trifrobert/Bachelor-Project/Graphical Resources/Tests/OverheatBatteryNotification.jpg

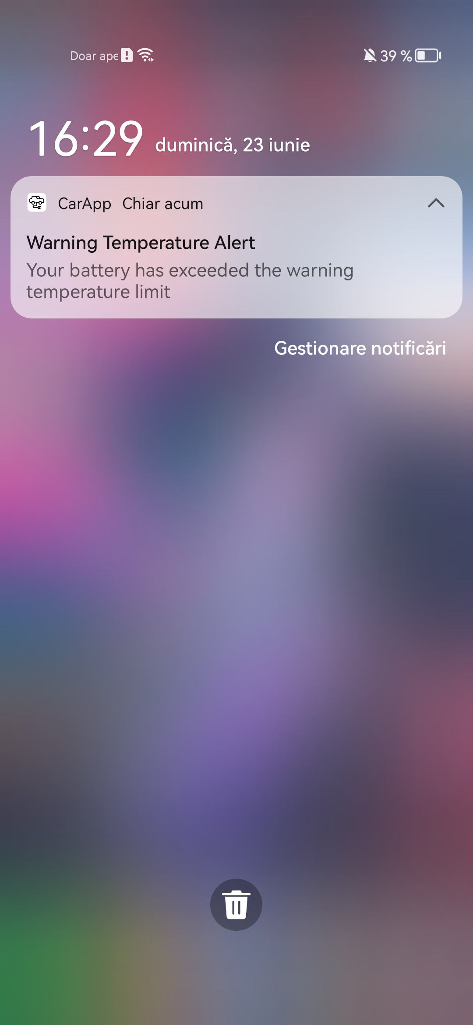
Graphical Resources/Tests/OverheatBatteryNotification.jpg
