trifrobert/Bachelor-Project/Graphical Resources/Tests/TestFullyChargedNotification.jpg

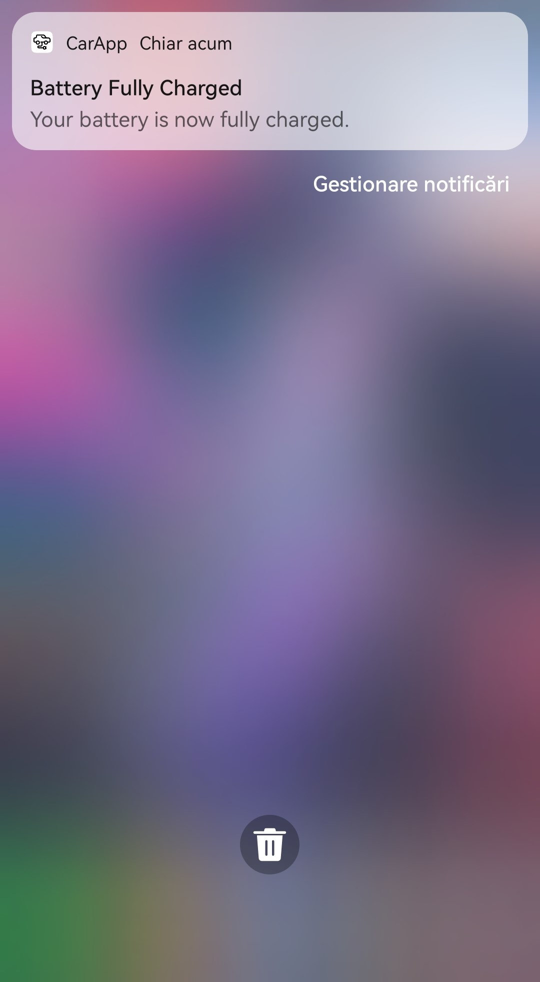
Graphical Resources/Tests/TestFullyChargedNotification.jpg
