trifrobert/Bachelor-Project/Graphical Resources/Code Snippets/chargingAlgorithm.png

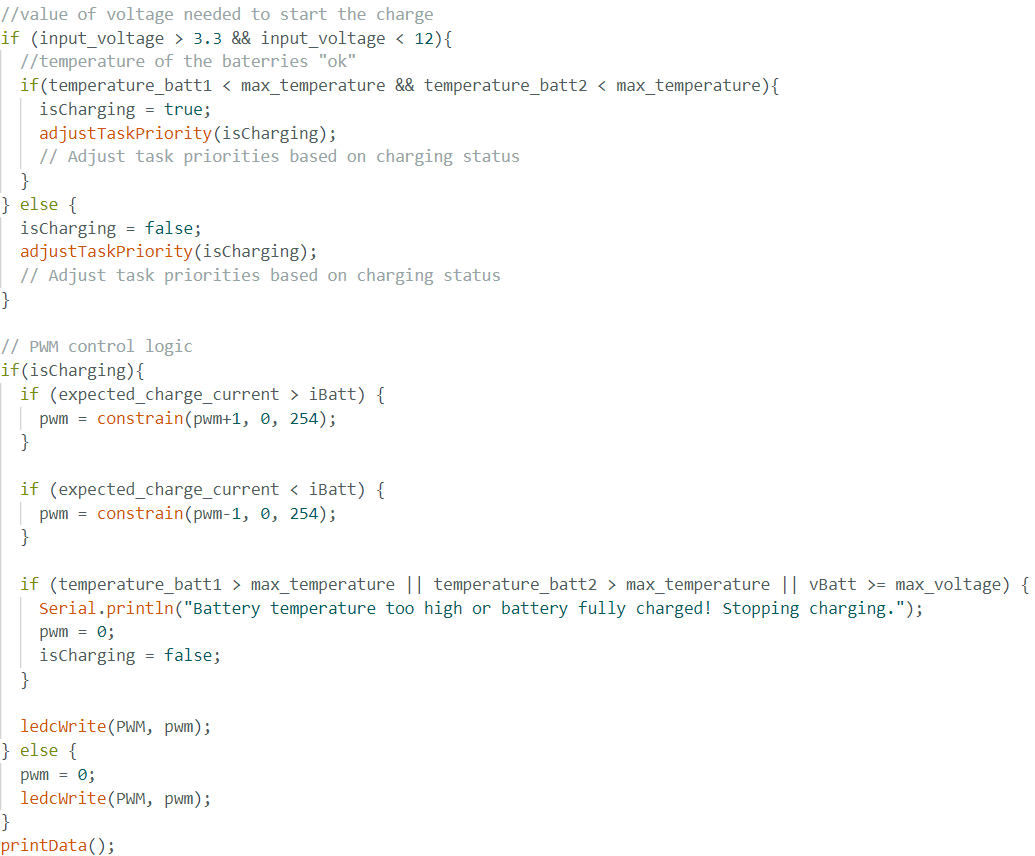
Graphical Resources/Code Snippets/chargingAlgorithm.png
