trifrobert/Bachelor-Project/Graphical Resources/Code Snippets/Expo project configuration.png

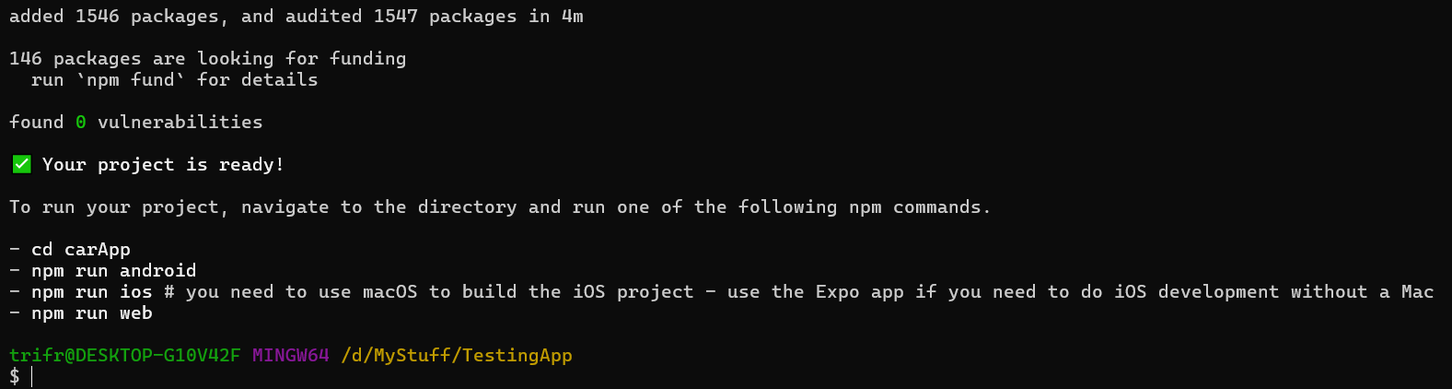
Graphical Resources/Code Snippets/Expo project configuration.png
