trifrobert/Bachelor-Project/Graphical Resources/Code Snippets/Firebase Admin SDK connection.png

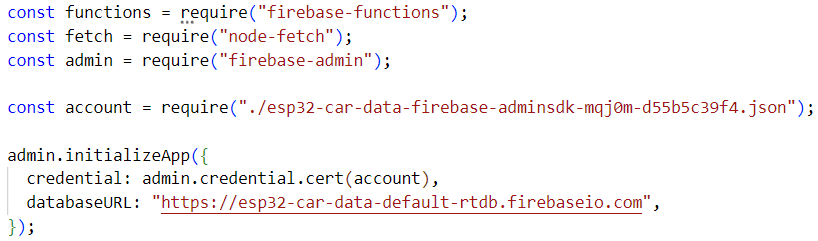
Graphical Resources/Code Snippets/Firebase Admin SDK connection.png
