trifrobert/Bachelor-Project/Graphical Resources/Code Snippets/Firebase connection.png

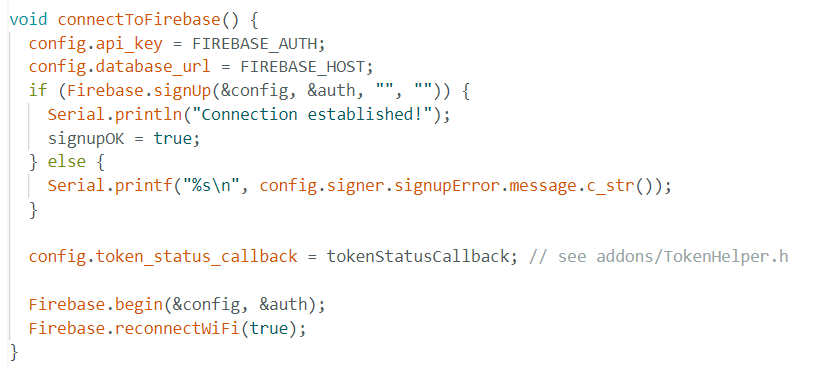
Graphical Resources/Code Snippets/Firebase connection.png
