trifrobert/Bachelor-Project/Graphical Resources/Code Snippets/Firebase console.jpg

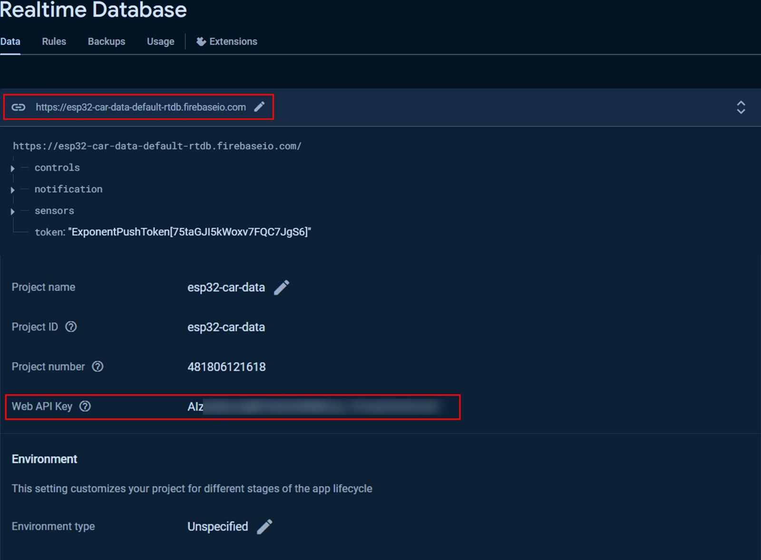
Graphical Resources/Code Snippets/Firebase console.jpg
