trifrobert/Bachelor-Project/Graphical Resources/Code Snippets/Firebase console.png

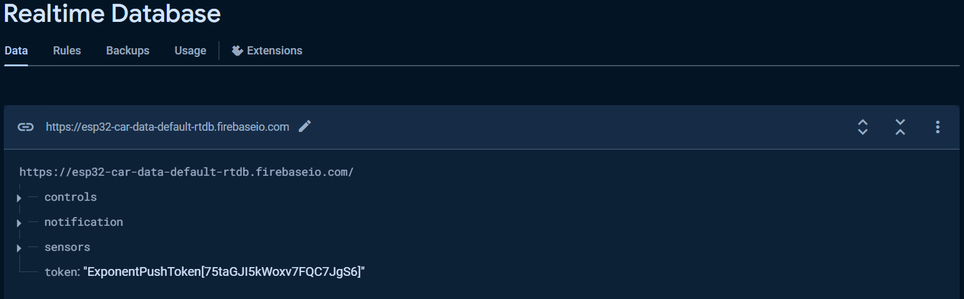
Graphical Resources/Code Snippets/Firebase console.png
