trifrobert/Bachelor-Project/Graphical Resources/Code Snippets/Firebase-Client Side.png

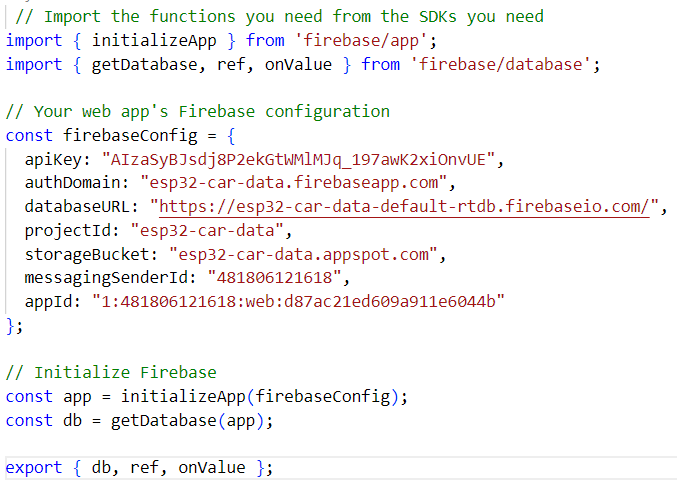
Graphical Resources/Code Snippets/Firebase-Client Side.png
