trifrobert/Bachelor-Project/Graphical Resources/Code Snippets/firebaseTask.png

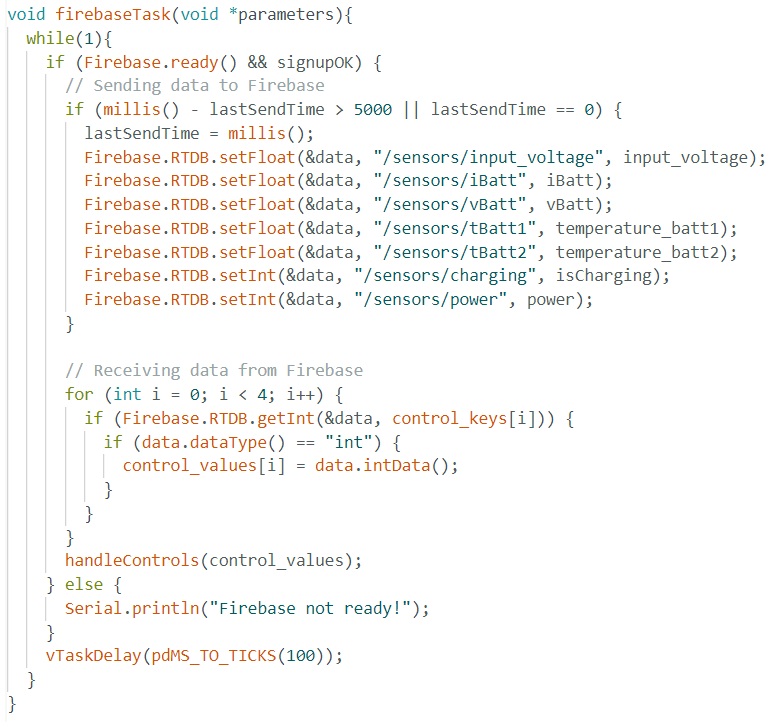
Graphical Resources/Code Snippets/firebaseTask.png
