trifrobert/Bachelor-Project/Graphical Resources/Code Snippets/getInputVoltage function.png

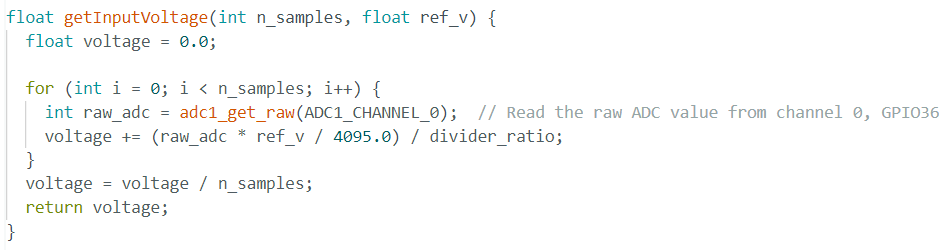
Graphical Resources/Code Snippets/getInputVoltage function.png
