trifrobert/Bachelor-Project/Graphical Resources/Code Snippets/HTTPS Request.png

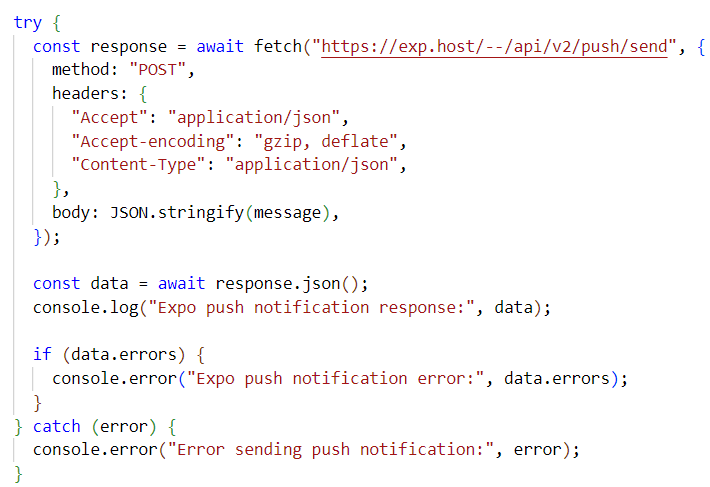
Graphical Resources/Code Snippets/HTTPS Request.png
