trifrobert/Bachelor-Project/Graphical Resources/Code Snippets/panResponder.png

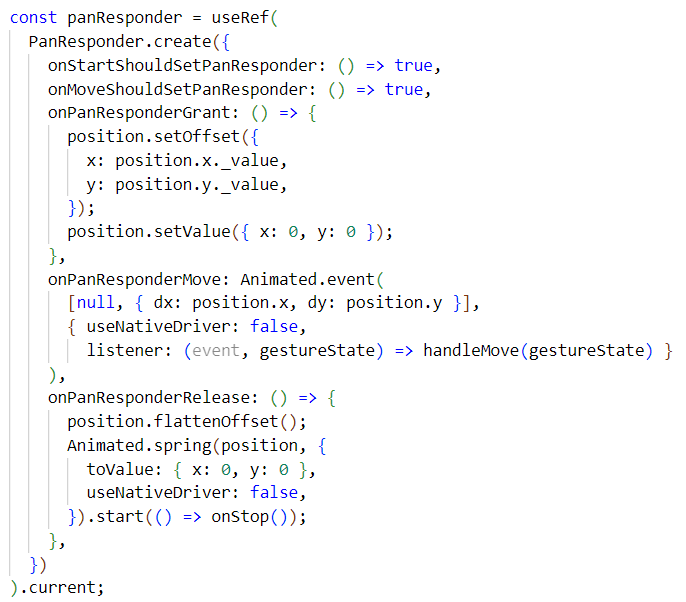
Graphical Resources/Code Snippets/panResponder.png
