trifrobert/Bachelor-Project/Graphical Resources/Code Snippets/Tasks.png

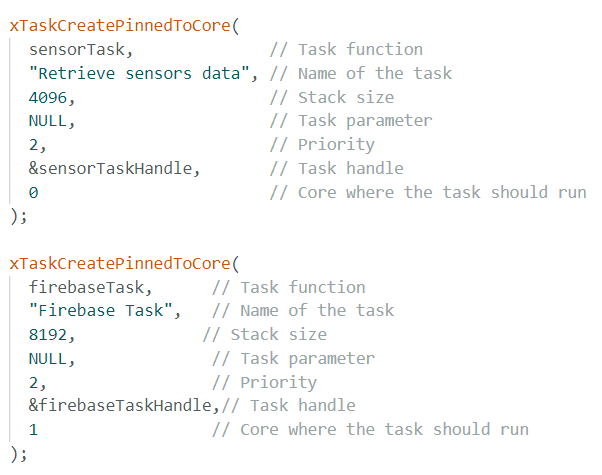
Graphical Resources/Code Snippets/Tasks.png
