trifrobert/Bachelor-Project/Graphical Resources/Code Snippets/Wi-Fi connection.png

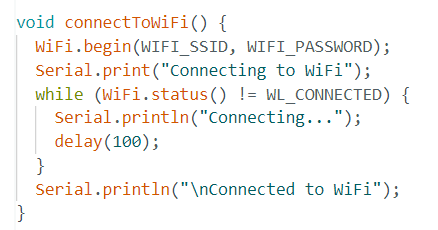
Graphical Resources/Code Snippets/Wi-Fi connection.png
