trifrobert/Bachelor-Project/Graphical Resources/Configure Expo project.png

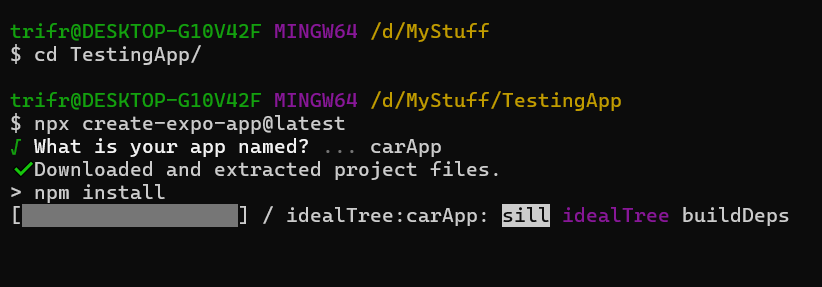
Graphical Resources/Configure Expo project.png
