trifrobert/Bachelor-Project/Graphical Resources/Electric Car Growth.png

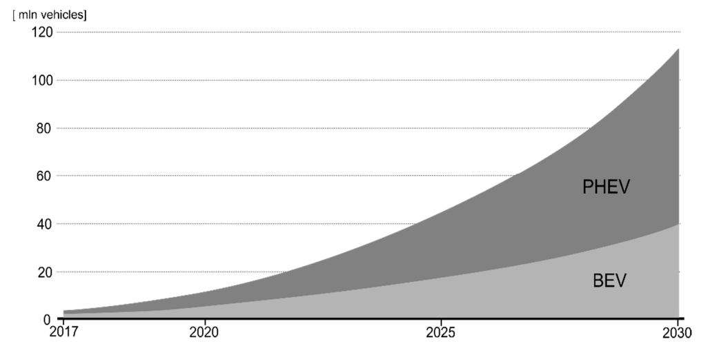
Graphical Resources/Electric Car Growth.png
