trifrobert/Bachelor-Project/Graphical Resources/handleControls().png

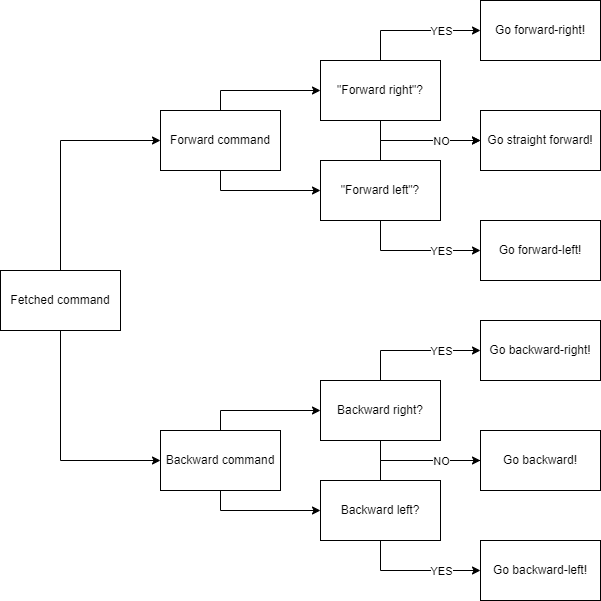
Graphical Resources/handleControls().png
