trifrobert/Bachelor-Project/Graphical Resources/INA219_Diagram.png

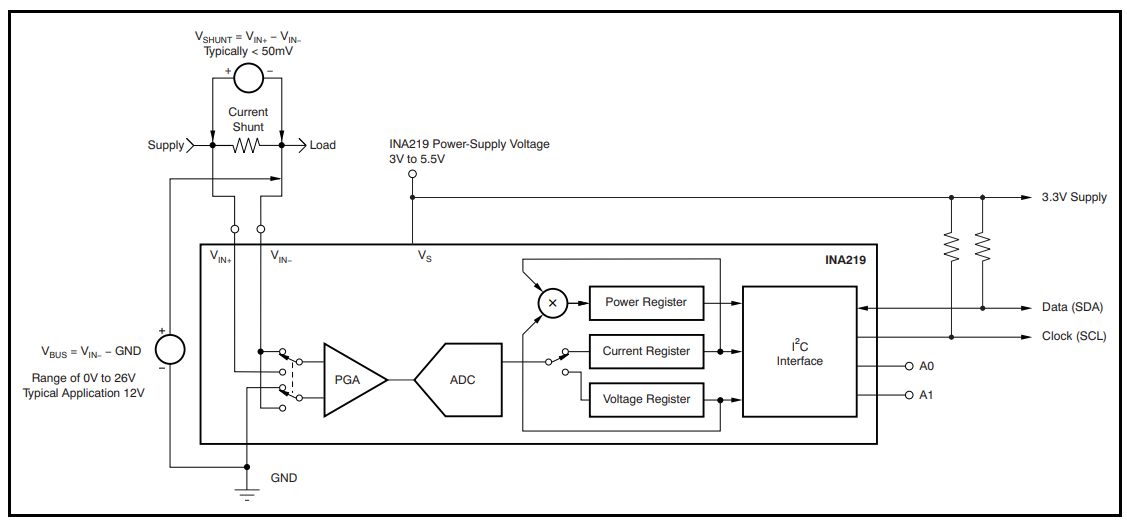
Graphical Resources/INA219_Diagram.png
