trifrobert/Bachelor-Project/Graphical Resources/Project Structure.png

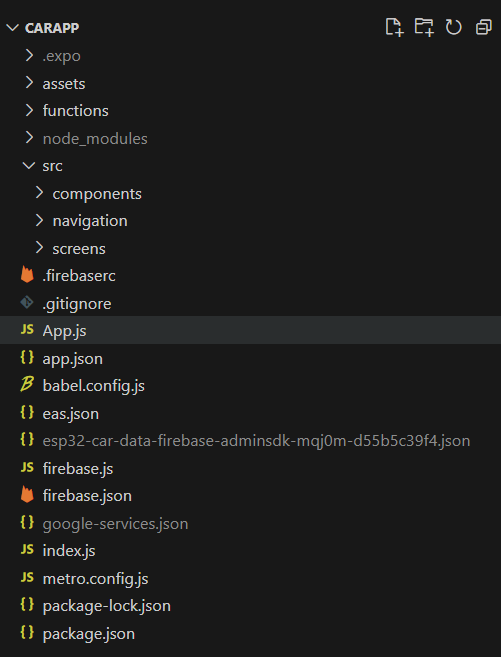
Graphical Resources/Project Structure.png
