trifrobert/Bachelor-Project/Graphical Resources/Use Case diagram.jpg

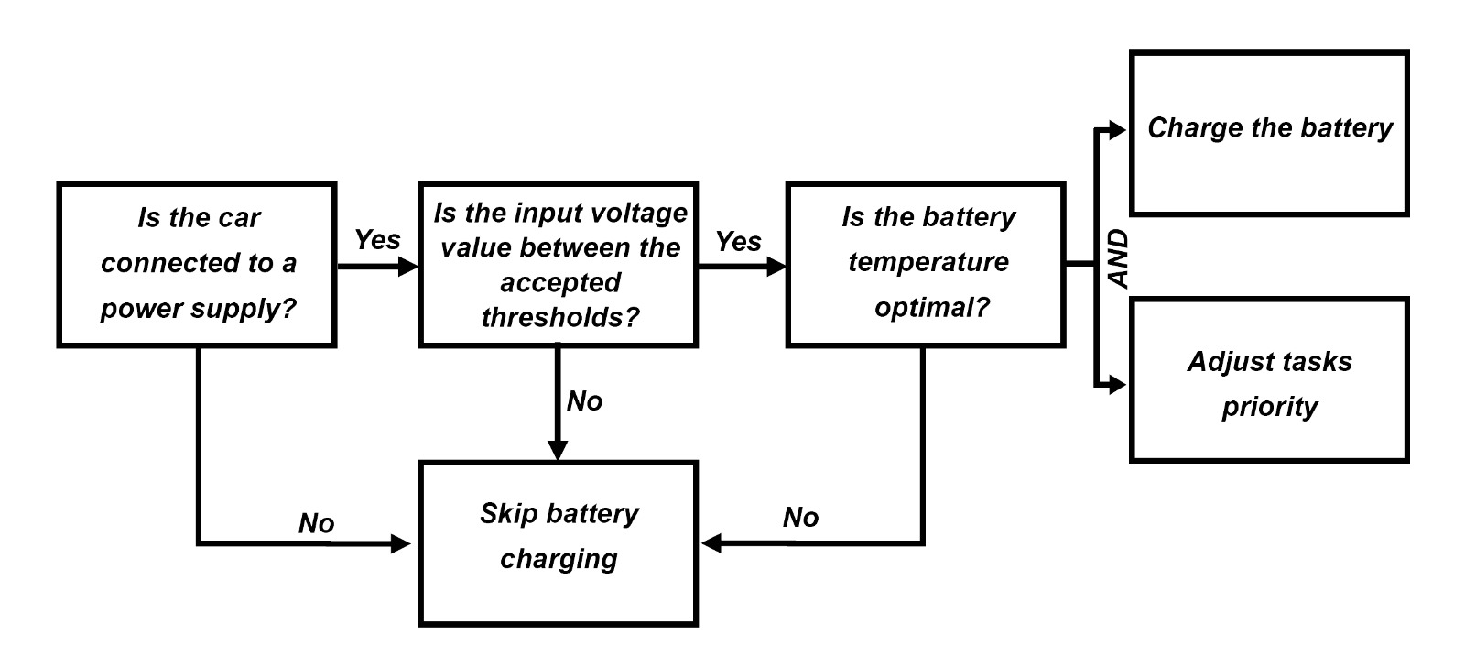
Graphical Resources/Use Case diagram.jpg
