trifrobert/Bachelor-Project/Graphical Resources/voltage 2.png

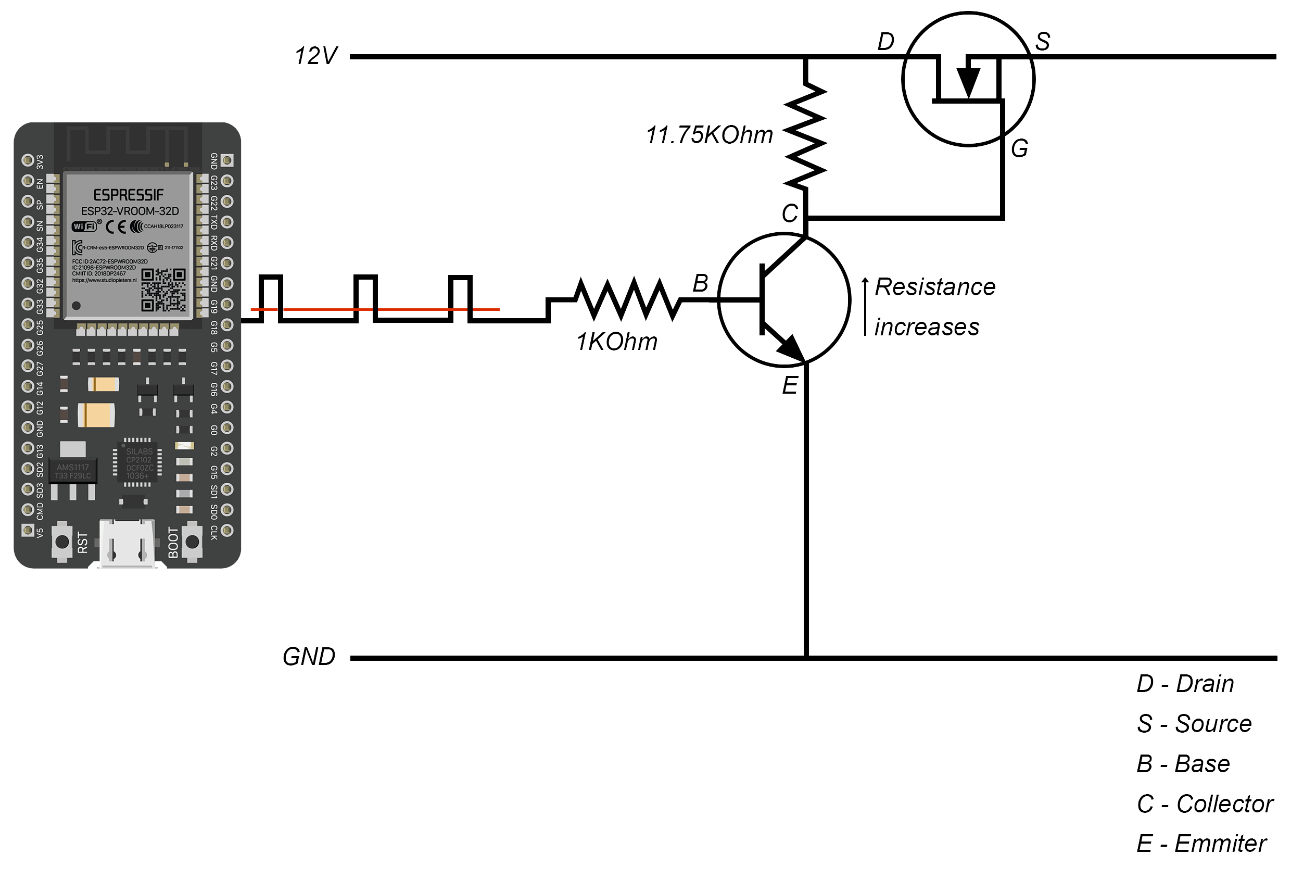
Graphical Resources/voltage 2.png
