trifrobert/Bachelor-Project/MobileApp/CarApp/assets/images/arrow_down.png

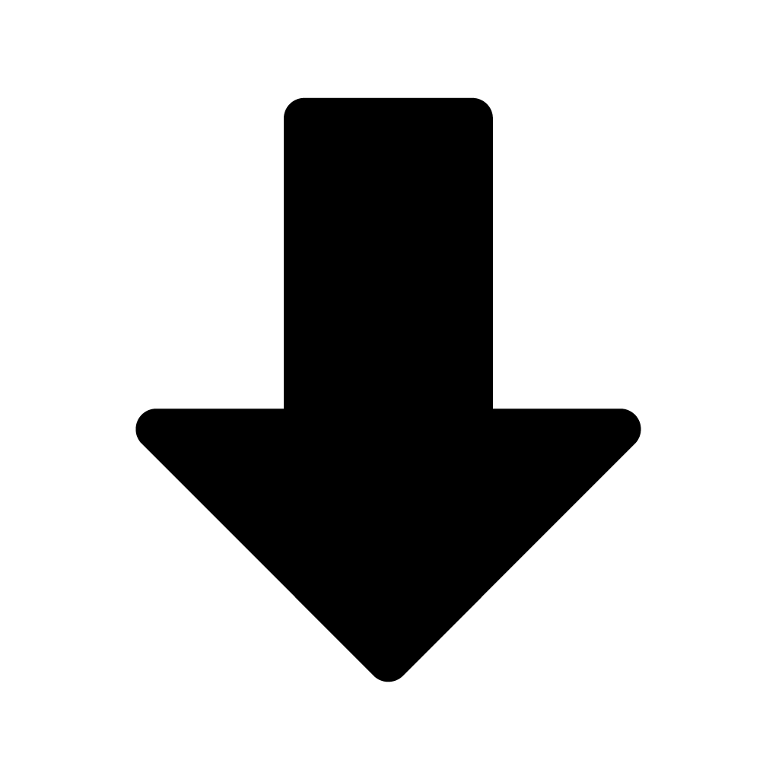
MobileApp/CarApp/assets/images/arrow_down.png
