trifrobert/Bachelor-Project/MobileApp/CarApp/assets/images/arrow_up.png

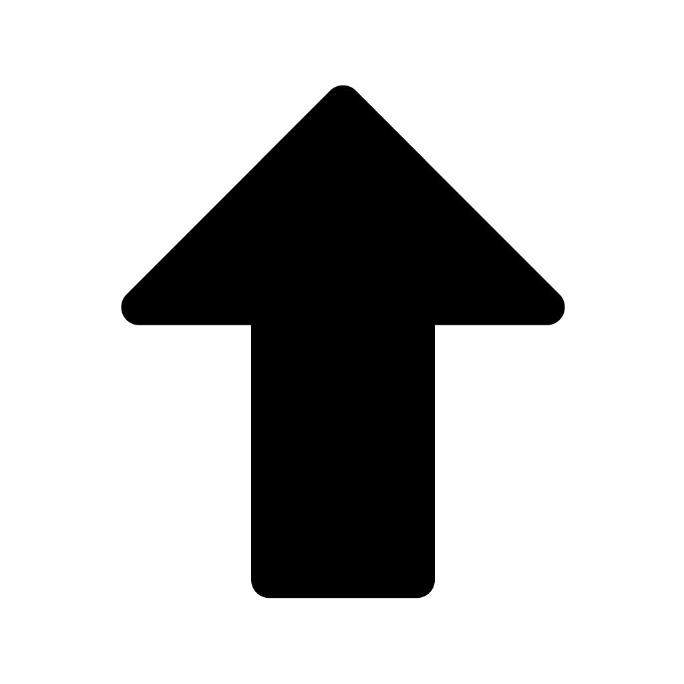
MobileApp/CarApp/assets/images/arrow_up.png
