trifrobert/Bachelor-Project/MobileApp/CarApp/assets/images/batt1.png

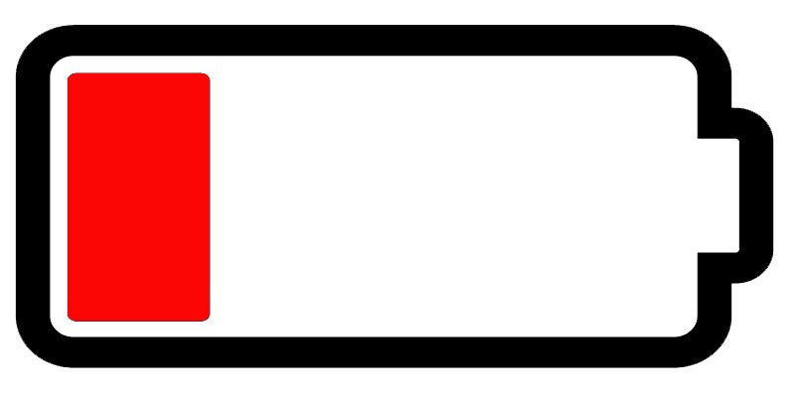
MobileApp/CarApp/assets/images/batt1.png
