trifrobert/Bachelor-Project/MobileApp/CarApp/assets/images/batt2.png

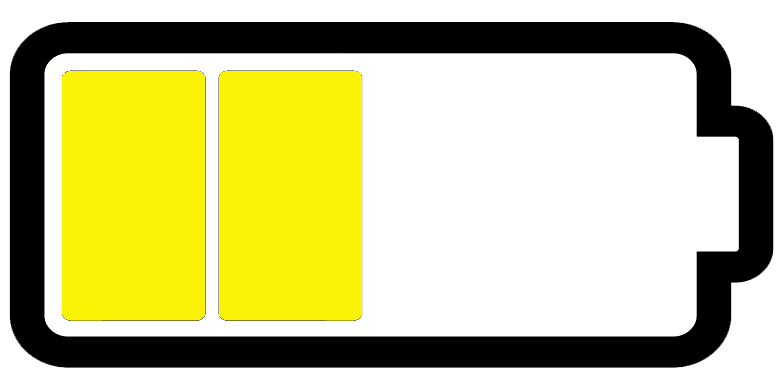
MobileApp/CarApp/assets/images/batt2.png
