trifrobert/Bachelor-Project/MobileApp/CarApp/assets/images/batt3.png

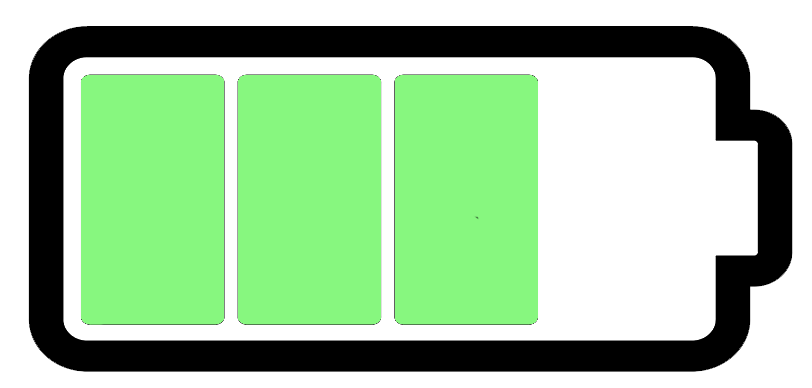
MobileApp/CarApp/assets/images/batt3.png
