trifrobert/Bachelor-Project/MobileApp/CarApp/assets/images/current.png

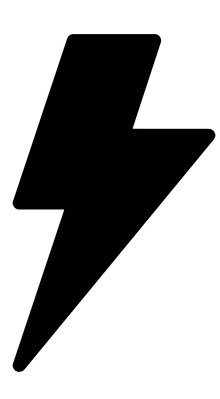
MobileApp/CarApp/assets/images/current.png
