trifrobert/Bachelor-Project/MobileApp/CarApp/assets/images/polarity.png

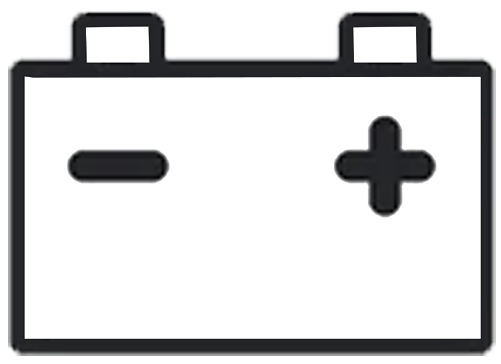
MobileApp/CarApp/assets/images/polarity.png
