trifrobert/Bachelor-Project/Graphical Resources/Code Snippets/ButtonComponent.png

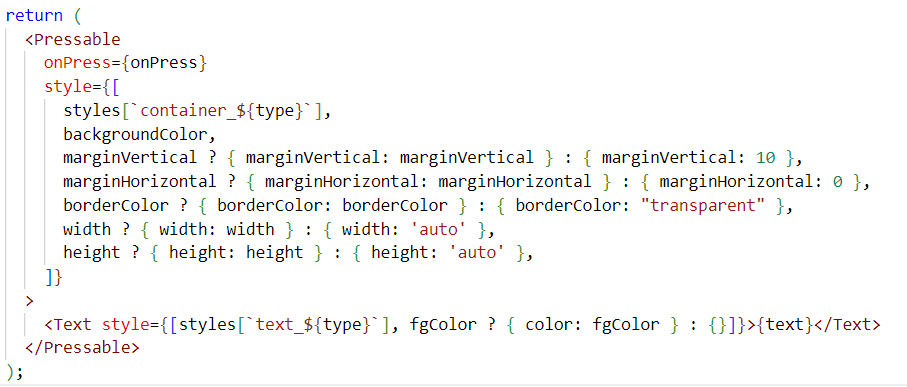
Graphical Resources/Code Snippets/ButtonComponent.png
