trifrobert/Bachelor-Project/Graphical Resources/Controller component.png

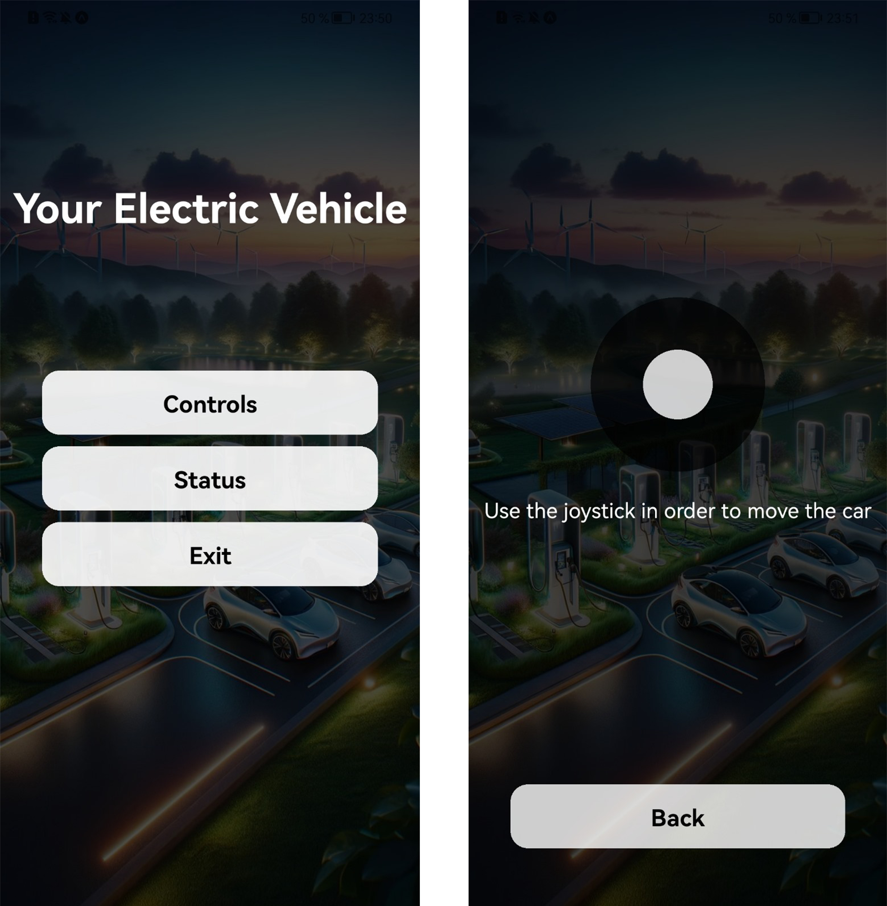
Graphical Resources/Controller component.png
