trifrobert/Bachelor-Project/Graphical Resources/View component.png

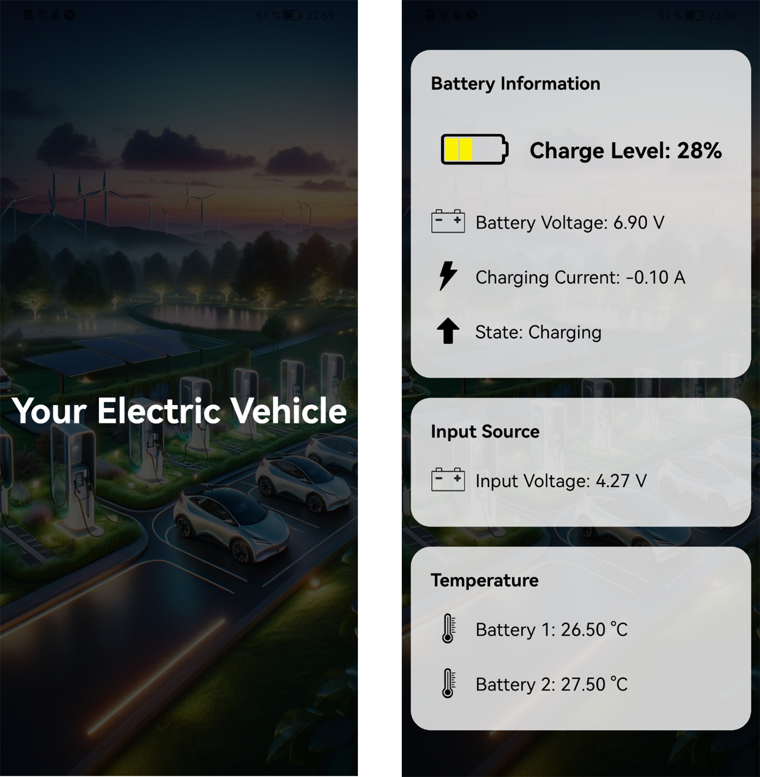
Graphical Resources/View component.png
