trifrobert/Bachelor-Project/(list of files, cad)

Other CAD files:
3D_Sasiu/Chassis.3dm
