trifrobert/Bachelor-Project/Graphical Resources/Tests/Battery Temperatures.png

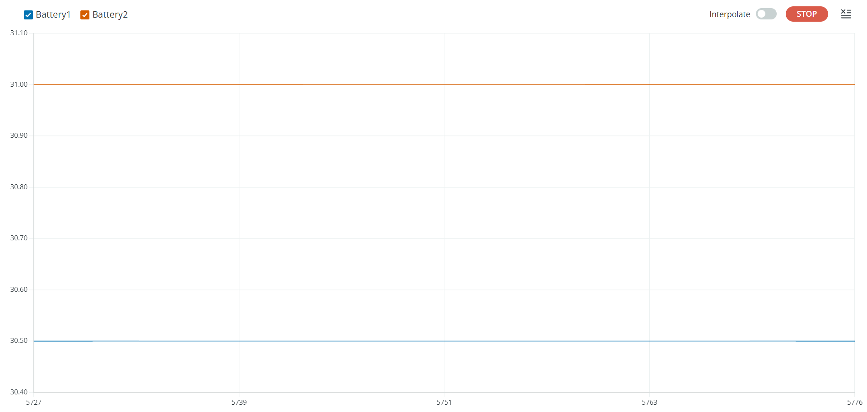
Graphical Resources/Tests/Battery Temperatures.png
