trifrobert/Bachelor-Project/Graphical Resources/Tests/Charging State and Input Voltage.png

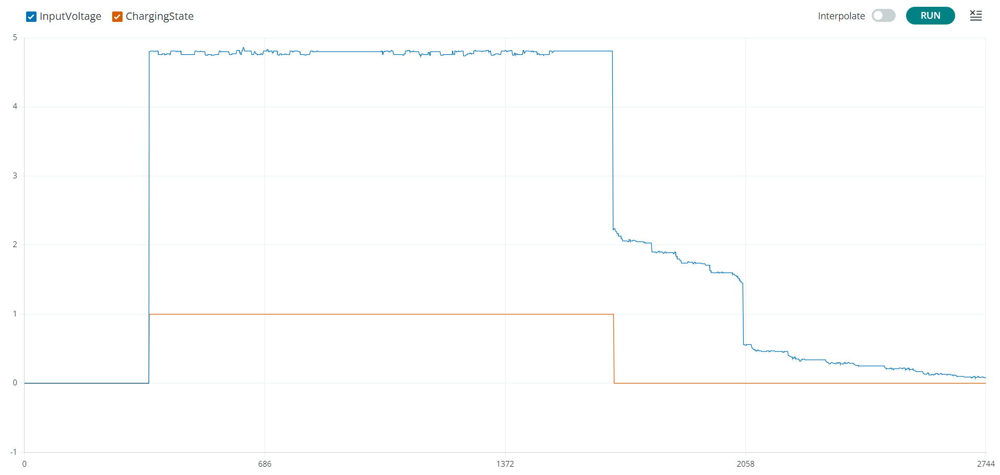
Graphical Resources/Tests/Charging State and Input Voltage.png
