trifrobert/Bachelor-Project/Graphical Resources/Tests/Current Sensor.png

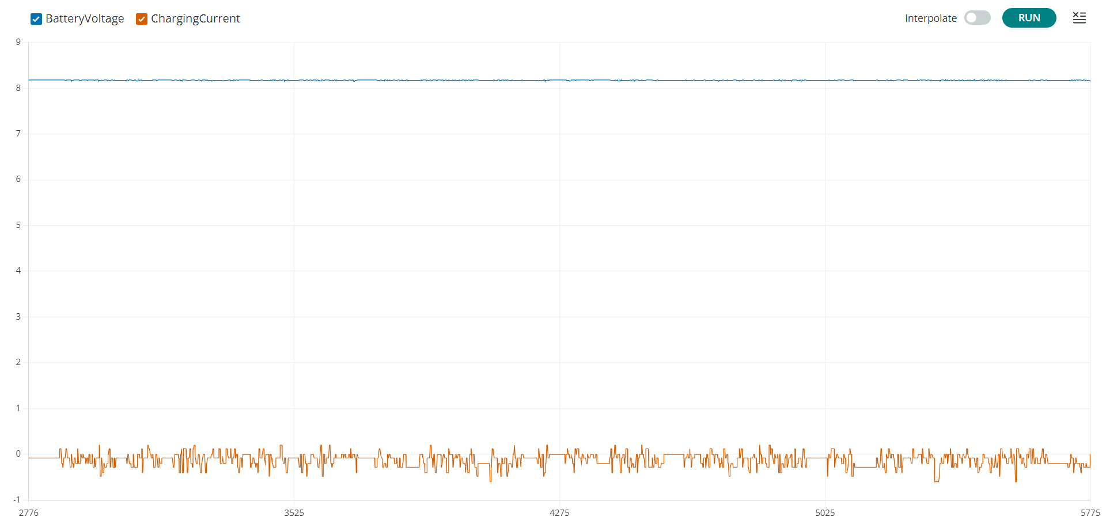
Graphical Resources/Tests/Current Sensor.png
