trifrobert/Bachelor-Project/Graphical Resources/Tests/Discharged.jpg

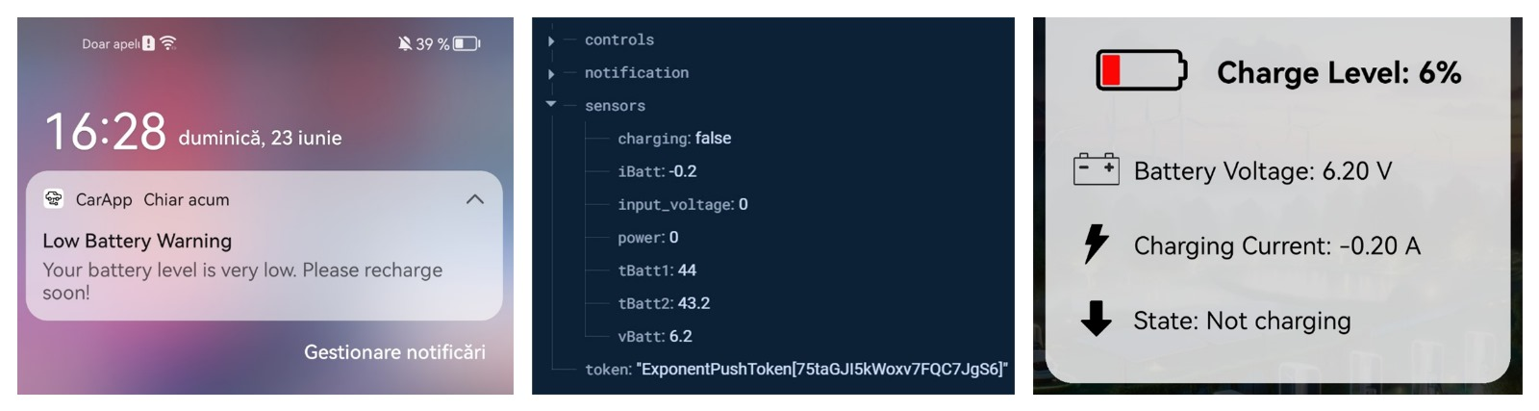
Graphical Resources/Tests/Discharged.jpg
