trifrobert/Bachelor-Project/Graphical Resources/Tests/Distance.png

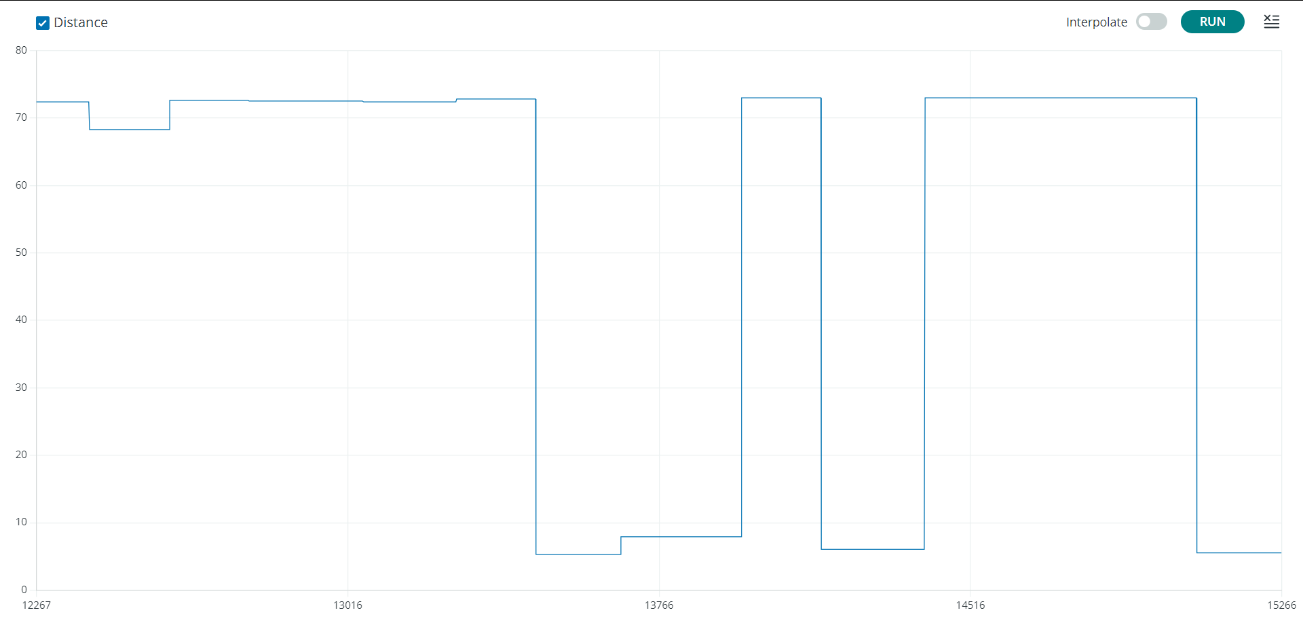
Graphical Resources/Tests/Distance.png
