trifrobert/Bachelor-Project/Graphical Resources/Tests/FullyCharged.jpg

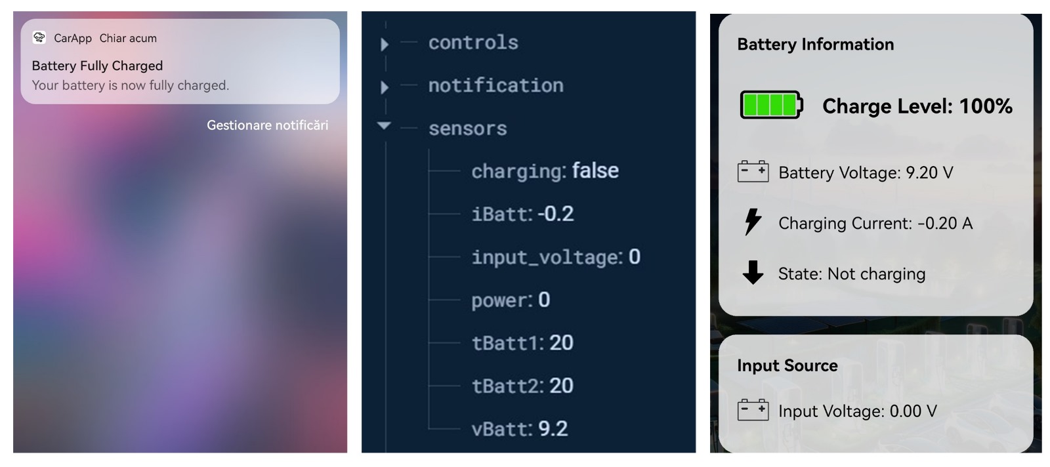
Graphical Resources/Tests/FullyCharged.jpg
