trifrobert/Bachelor-Project/Graphical Resources/Tests/LowBatteryApplication.jpg

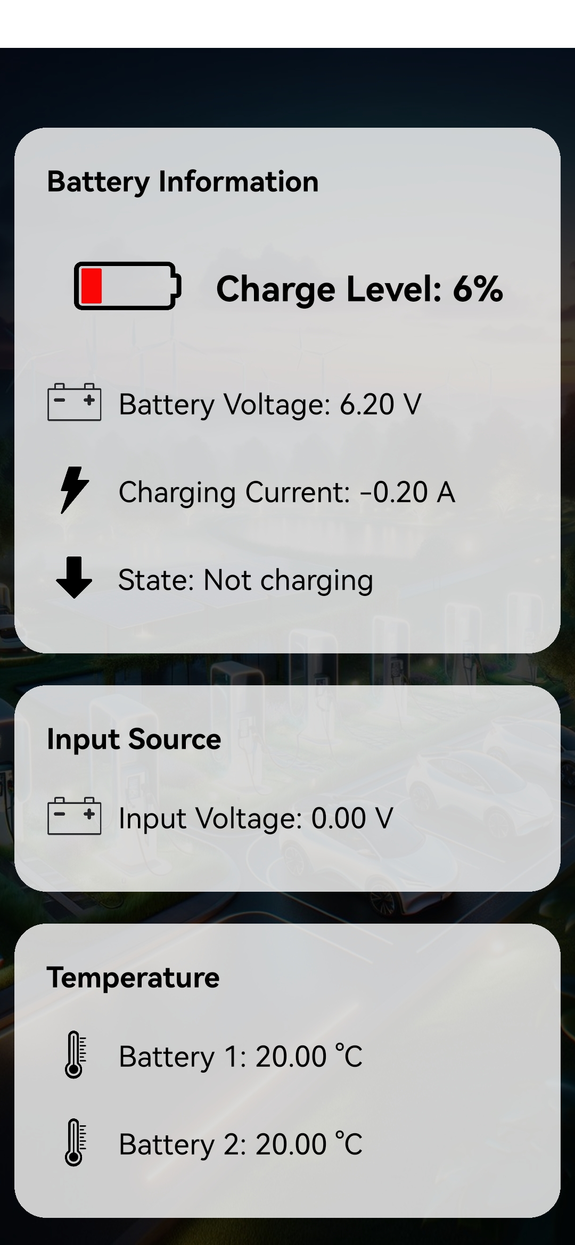
Graphical Resources/Tests/LowBatteryApplication.jpg
