trifrobert/Bachelor-Project/Graphical Resources/Tests/LowBatteryConsole.png

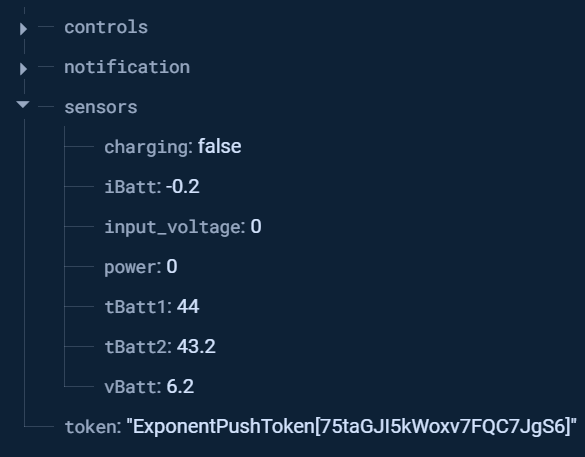
Graphical Resources/Tests/LowBatteryConsole.png
