trifrobert/Bachelor-Project/Graphical Resources/Tests/PWM.png

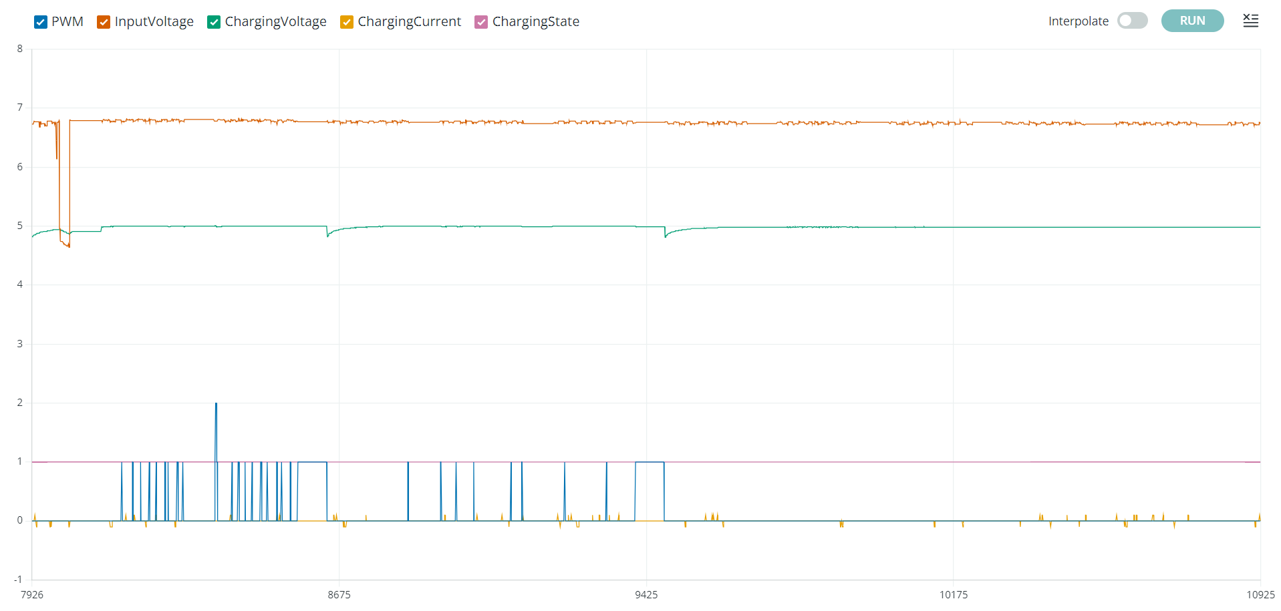
Graphical Resources/Tests/PWM.png
