trifrobert/Bachelor-Project/Graphical Resources/Tests/Temperature Exeeded.png

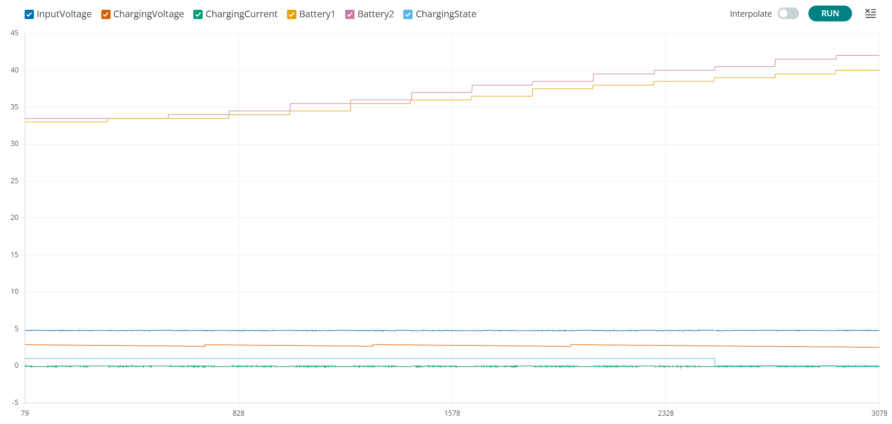
Graphical Resources/Tests/Temperature Exeeded.png
