trifrobert/Bachelor-Project/Graphical Resources/Tests/TestFullyCharged.png

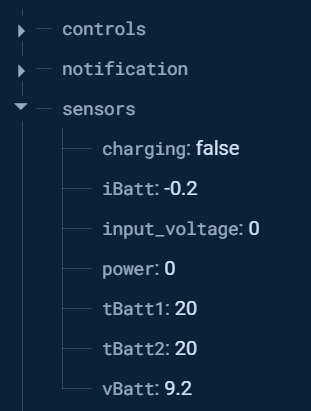
Graphical Resources/Tests/TestFullyCharged.png
