trifrobert/Bachelor-Project/Graphical Resources/Tests/TestFullyChargedApplication.jpg

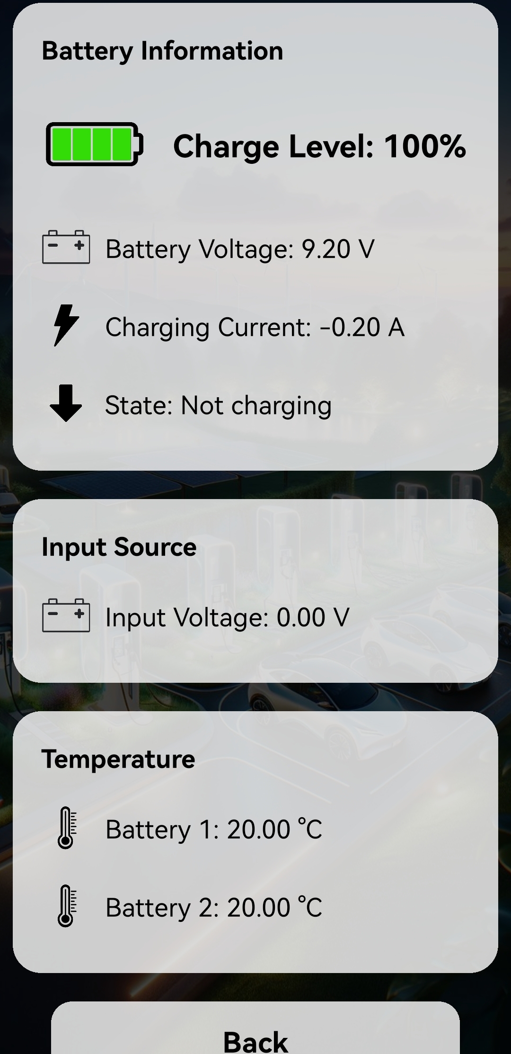
Graphical Resources/Tests/TestFullyChargedApplication.jpg
