trifrobert/Bachelor-Project/ESP32_Code/Code/Code.ino

#include <Wire.h>
#include <OneWire.h>
#include <DallasTemperature.h>
#include <Adafruit_INA219.h>
#include <driver/adc.h>
#include <WiFi.h>
#include <Firebase_ESP_Client.h>
#include "addons/TokenHelper.h"
#include "addons/RTDBHelper.h"
#include "FirebaseConfig.h"

#define ONE_WIRE_BUS 32   // Temperature Sensors configuration pin

// Ultrasonic sensor
const int echoPin = 15;
const int trigPin = 16;
const int pUltraSonic = 17;
float duration, distance;

// Wi-Fi and Realtime Database Connection
WiFiClient wifiClient;
FirebaseData data;
FirebaseAuth auth;
FirebaseConfig config;
bool signupOK = false;
unsigned long lastSendTime = 0;
unsigned long lastTempSent = 0;

Adafruit_INA219 ina_219;  // Instance of current module
float input_voltage = 0;    // Volts
float iBatt = 0;  // Charging current - mAmpers
float vBatt = 0;    // Battery voltage - Volts
float power = 0;  // Charging power - mW

const int PWM = 23;   // Corresponds to GPIO23
const int pwm_channel = 6;
const int frequency = 30000;   // Hz
const int resolution = 8; 
int pwm = 0;
bool isCharging = false;

const float expected_charge_current = 20; // Constant charging current in mA (0.05C for 400mAh batteries) for trickle charge
const float max_temperature = 40;     // Maximum temperature in °C
const float max_voltage = 9.2;    // Maximum voltage for two 9V NiMH batteries in parallel

// Motor driver configuration
int motorspeed_l = 33;
int leftMotors_pin1 = 25;
int leftMotors_pin2 = 26;
int rightMotors_pin1 = 27;
int rightMotors_pin2 = 14;
int motorspeed_r = 12;

// Access for Dallas temperature sensors
OneWire oneWire(ONE_WIRE_BUS);
DallasTemperature sensors(&oneWire);
DeviceAddress sensor1, sensor2;
float temperature_batt1 = 0;
float temperature_batt2 = 0;

const float divider_ratio = 0.2985;   // Voltage divider ratio based on resistances value: 10 / (23.5 + 10)

const char* control_keys[4] = {"/controls/control_up", "/controls/control_down", "/controls/control_left", "/controls/control_right"};
int control_values[4];

TaskHandle_t firebaseTaskHandle;
TaskHandle_t sensorTaskHandle;

float getInputVoltage(int n_samples, float ref_v) {
  float voltage = 0.0;

  for (int i = 0; i < n_samples; i++) {
    int raw_adc = adc1_get_raw(ADC1_CHANNEL_0);  // Read the raw ADC value from channel 0, GPIO36
    voltage += (raw_adc * ref_v / 4095.0) / divider_ratio;
  }
  voltage = voltage / n_samples;
  return voltage;
}

void connectToWiFi() {
  WiFi.begin(WIFI_SSID, WIFI_PASSWORD);
  Serial.print("Connecting to WiFi");
  while (WiFi.status() != WL_CONNECTED) {
    Serial.println("Connecting...");
    delay(100);
  }
  Serial.println("\nConnected to WiFi");
}

void connectToFirebase() {
  config.api_key = FIREBASE_AUTH;
  config.database_url = FIREBASE_HOST;
  if (Firebase.signUp(&config, &auth, "", "")) {
    Serial.println("Connection established!");
    signupOK = true;
  } else {
    Serial.printf("%s\n", config.signer.signupError.message.c_str());
  }

  config.token_status_callback = tokenStatusCallback; // see addons/TokenHelper.h

  Firebase.begin(&config, &auth);
  Firebase.reconnectWiFi(true);
}

void handleControls(int control_arr[]){
  if(control_arr[0] == 1){
    if(control_arr[2] == 1){
      //FRONT-LEFT
      digitalWrite(leftMotors_pin1, LOW);
      digitalWrite(leftMotors_pin2, LOW);
      digitalWrite(rightMotors_pin1, HIGH);
      digitalWrite(rightMotors_pin2, LOW);
    }
    else if(control_arr[3] == 1){
      //FRONT-RIGHT
      digitalWrite(leftMotors_pin1, LOW);
      digitalWrite(leftMotors_pin2, HIGH);
      digitalWrite(rightMotors_pin1, LOW);
      digitalWrite(rightMotors_pin2, LOW);
    }
    else{
      //FRONT
      digitalWrite(leftMotors_pin1, LOW);
      digitalWrite(leftMotors_pin2, HIGH);
      digitalWrite(rightMotors_pin1, HIGH);
      digitalWrite(rightMotors_pin2, LOW);
    }
  }
  else if(control_arr[1] == 1){
    
    digitalWrite(trigPin, LOW);
    delayMicroseconds(2);
    digitalWrite(trigPin, HIGH);
    delayMicroseconds(10);
    digitalWrite(trigPin, LOW);
    
    duration = pulseIn(echoPin, HIGH);
    distance = duration / 58.2;

    if (distance > 8){
      if(control_arr[2] == 1){
        //BACKWARD-LEFT
        digitalWrite(leftMotors_pin1, LOW);
        digitalWrite(leftMotors_pin2, LOW);
        digitalWrite(rightMotors_pin1, LOW);
        digitalWrite(rightMotors_pin2, HIGH);
      }
      else if(control_arr[3] == 1){
        //BACKWARD-RIGHT
        digitalWrite(leftMotors_pin1, HIGH);
        digitalWrite(leftMotors_pin2, LOW);
        digitalWrite(rightMotors_pin1, LOW);
        digitalWrite(rightMotors_pin2, LOW);
      }
      else{
        //BACKWARD
        digitalWrite(leftMotors_pin1, HIGH);
        digitalWrite(leftMotors_pin2, LOW);
        digitalWrite(rightMotors_pin1, LOW);
        digitalWrite(rightMotors_pin2, HIGH);
      }
    }
  }
  else{
    //STATIONARY
    digitalWrite(leftMotors_pin1, LOW);
    digitalWrite(leftMotors_pin2, LOW);
    digitalWrite(rightMotors_pin1, LOW);
    digitalWrite(rightMotors_pin2, LOW);
  }
}

void printData(void) {
  Serial.print("PWM Value: ");
  Serial.println(pwm);
  Serial.print("Input voltage:         "); Serial.print(input_voltage); Serial.println(" V");
  Serial.print("Battery Voltage:       "); Serial.print(vBatt); Serial.println(" V");
  Serial.print("Charging Current:      "); Serial.print(iBatt); Serial.println(" mA");
  Serial.print("Power:                 "); Serial.print(power); Serial.println(" mW");
  Serial.print("Battery 1 Temperature: "); Serial.print(temperature_batt1); Serial.println(" °C");
  Serial.print("Battery 2 Temperature: "); Serial.print(temperature_batt2); Serial.println(" °C");
  Serial.print("Charging:              "); Serial.println(isCharging);
  Serial.print("Distance:              "); Serial.print(distance); Serial.println(" cm");
  Serial.println();
}

void printDataForPlotter(void) {
  // Serial.print("PWM:");
  // Serial.print(pwm);
  // Serial.print(",");
  Serial.print("InputVoltage:");
  Serial.print(input_voltage);
  Serial.print(",");
  Serial.print("ChargingVoltage:");
  Serial.print(vBatt);
  Serial.print(",");
  Serial.print("ChargingCurrent:");
  Serial.print(iBatt);
  Serial.print(",");
  // Serial.print(power);
  // Serial.print(",");
  Serial.print("Battery1:");
  Serial.print(temperature_batt1);
  Serial.print(",");
  Serial.print("Battery2:");
  Serial.print(temperature_batt2);
  Serial.print(",");
  Serial.print("ChargingState:");
  Serial.print(isCharging);
  Serial.print(",");
  // Serial.print("Distance:");
  // Serial.print(distance);
  Serial.println();
}

void adjustTaskPriority(bool isCharging){
  if(isCharging){
    vTaskPrioritySet(firebaseTaskHandle, 1);
    vTaskPrioritySet(sensorTaskHandle, 3);
  }
  else{
    vTaskPrioritySet(firebaseTaskHandle, 2);
    vTaskPrioritySet(sensorTaskHandle, 2);
  }
}

void sensorTask(void *parameters){
  while(1){
    input_voltage = getInputVoltage(10, 3.3);
    iBatt = ina_219.getCurrent_mA();
    vBatt = ina_219.getBusVoltage_V() + (ina_219.getShuntVoltage_mV() / 1000);
    power = ina_219.getPower_mW();

    if (millis() - lastTempSent > 2000 || lastTempSent == 0) {
      lastTempSent = millis();
      sensors.requestTemperatures();
      temperature_batt1 = sensors.getTempC(sensor1);
      temperature_batt2 = sensors.getTempC(sensor2);
    }

    //value of voltage needed to start the charge
    if (input_voltage > 3.3 && input_voltage < 12){  
      //temperature of the baterries "ok"
      if(temperature_batt1 < max_temperature && temperature_batt2 < max_temperature){   
        isCharging = true;
        adjustTaskPriority(isCharging);
        // Adjust task priorities based on charging status
      }
    } else {
      isCharging = false;
      adjustTaskPriority(isCharging);
      // Adjust task priorities based on charging status
    }

    // PWM control logic
    if(isCharging){
      // if (expected_charge_current > iBatt) {
      //   pwm = constrain(pwm+1, 0, 254);
      // }

      // if (expected_charge_current < iBatt) {
      //   pwm = constrain(pwm-1, 0, 254);
      // }

      if (2.75 < vBatt) {
        pwm = constrain(pwm+1, 0, 254);
      }

      if (2.75 > vBatt) {
        pwm = constrain(pwm-1, 0, 254);
      }

      if (temperature_batt1 > max_temperature || temperature_batt2 > max_temperature || vBatt >= max_voltage) {
        Serial.println("Battery temperature too high or battery fully charged! Stopping charging.");
        pwm = 254;
        isCharging = false;
      }

      ledcWrite(PWM, pwm);
    } else {
      pwm = 254;
      ledcWrite(PWM, pwm);
    }
    // printData();
    vTaskDelay(pdMS_TO_TICKS(10));
  }
}

void firebaseTask(void *parameters){
  while(1){
    if (Firebase.ready() && signupOK) {
      // Sending data to Firebase
      if (millis() - lastSendTime > 5000 || lastSendTime == 0) {
        lastSendTime = millis();
        Firebase.RTDB.setFloat(&data, "/sensors/input_voltage", input_voltage);
        Firebase.RTDB.setFloat(&data, "/sensors/iBatt", iBatt);
        Firebase.RTDB.setFloat(&data, "/sensors/vBatt", vBatt);
        Firebase.RTDB.setFloat(&data, "/sensors/tBatt1", temperature_batt1);
        Firebase.RTDB.setFloat(&data, "/sensors/tBatt2", temperature_batt2);
        Firebase.RTDB.setInt(&data, "/sensors/charging", isCharging);
        Firebase.RTDB.setInt(&data, "/sensors/power", power);
      }

      // Receiving data from Firebase
      for (int i = 0; i < 4; i++) {
        if (Firebase.RTDB.getInt(&data, control_keys[i])) {
          if (data.dataType() == "int") {
            control_values[i] = data.intData();
          }
        }
      }
      handleControls(control_values);
    } else {
      Serial.println("Firebase not ready!");
    }
    vTaskDelay(pdMS_TO_TICKS(200));
  }
}

void setup() {
  Serial.begin(115200);

  connectToWiFi();
  connectToFirebase();

  pinMode(leftMotors_pin1, OUTPUT);
  pinMode(leftMotors_pin2, OUTPUT);
  pinMode(rightMotors_pin1, OUTPUT);
  pinMode(rightMotors_pin2, OUTPUT);
  pinMode(motorspeed_l, OUTPUT);  // Controls the left motor speed - range(0, 255)
  pinMode(motorspeed_r, OUTPUT);  // Controls the right motor speed - range(0, 255)

  digitalWrite(motorspeed_l, HIGH);
  digitalWrite(motorspeed_r, HIGH);

  pinMode(trigPin, OUTPUT);
  pinMode(echoPin, INPUT);
  pinMode(pUltraSonic, OUTPUT);
  digitalWrite(pUltraSonic, HIGH);  // Sets the Vcc for Ultrasonic Sensor

  adc1_config_width(ADC_WIDTH_BIT_12);  // Set ADC resolution to 12 bits
  adc1_config_channel_atten(ADC1_CHANNEL_0, ADC_ATTEN_DB_11);  // Set attenuation to 11dB for 0-3.6V range

  ledcAttach(PWM, frequency, resolution);

  sensors.begin();
  sensors.setResolution(sensor1, 9);
  sensors.setResolution(sensor2, 9);

  if (!sensors.getAddress(sensor1, 0)) {
    Serial.println("Failed to find temperature sensor 1!");
  }
  if (!sensors.getAddress(sensor2, 1)) {
    Serial.println("Failed to find temperature sensor 2!");
  }

  while (!ina_219.begin()) {
    Serial.print("Failed to find module ina_219!");
    delay(1000);
  }
  ina_219.setCalibration_16V_400mA();
  Serial.println("Measuring voltage and current with INA219 module...");

  xTaskCreatePinnedToCore(
    sensorTask,              // Task function
    "Retrieve sensors data", // Name of the task
    4096,                    // Stack size
    NULL,                    // Task parameter
    2,                       // Priority
    &sensorTaskHandle,       // Task handle
    0                        // Core where the task should run
  );

  xTaskCreatePinnedToCore(
    firebaseTask,      // Task function
    "Firebase Task",   // Name of the task
    8192,             // Stack size 
    NULL,              // Task parameter
    2,                 // Priority
    &firebaseTaskHandle,// Task handle
    1                  // Core where the task should run
  );
}

void loop(void){
  printDataForPlotter();          // For human-readable serial output with labels
}
