trifrobert/Bachelor-Project/(commit log)

2024-04-23 Added diagrams: licenta & proiect_incipient
    [licenta.fzz, proiect_incipient.fzz]
2024-05-06 3D Model for car. Design updated.
    [licenta.fzz, șasiu robi.3dm]
2024-05-09 Starting the documentation. Small changes in design.
    [licenta.fzz]
2024-05-15 Replacing Arduino with ESP32.
2024-05-17 Temperature sensors. ESP32-pinout.
2024-05-22 Connection with actuators.
2024-05-23 Indentation fixes. StatusScreen created. Arduino code improvements.
2024-05-28 Buttons replaced with joystick. Control functionality - done.
2024-05-29 Charging algorithm. Temperature sensors active.
2024-06-23 Last update.
    [Chassis.3dm, licenta.fzz, proiect_incipient.fzz, șasiu robi.3dm]
